MatiCruzate/Estaci-n-de-Audio-R-tmica/Modelo 3D/Caja_audio_ritmica.FCStd

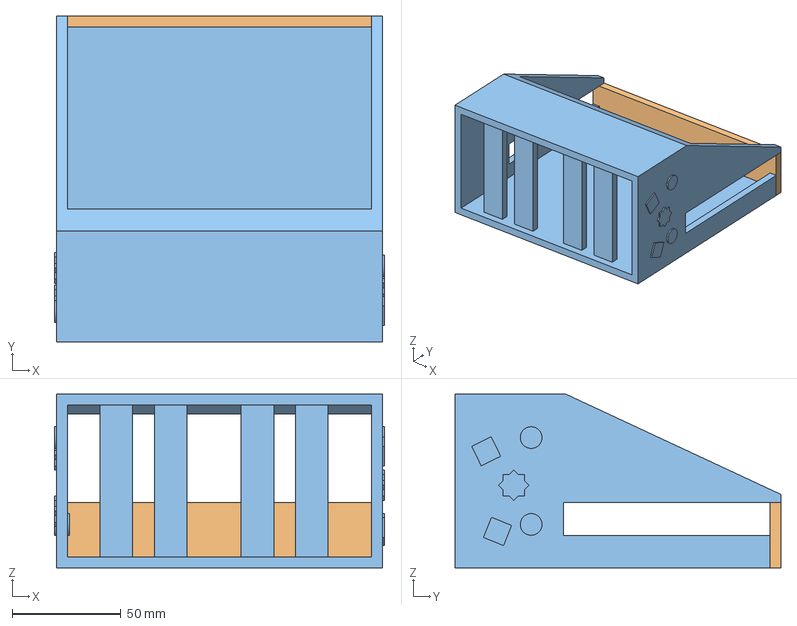
[picture p68: CAD file, 2024-02-26]
Modelo 3D/Caja_audio_ritmica.FCStd
152.0 x 150.0 x 80.0 mm
BooleanFragments
Cubo008
