MatiCruzate/Estaci-n-de-Audio-R-tmica/Modelo 3D/Caja_audio_ritmica-Fusion014.stl

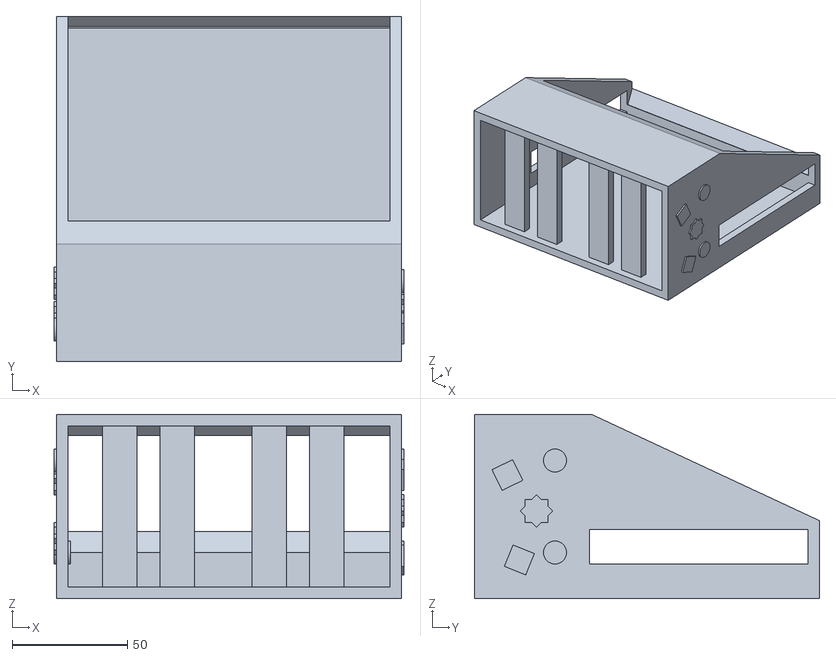
[picture p69: CAD file, 2024-02-26]
Modelo 3D/Caja_audio_ritmica-Fusion014.stl
152.0 x 150.0 x 80.0
