MatiCruzate/Estaci-n-de-Audio-R-tmica/Audio_Ritmica/Core/Src/main.c

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
/* Includes ------------------------------------------------------------------*/
#include "main.h"

/* USER CODE BEGIN Includes */
#include "arm_math.h"
#include <stdio.h>
#include <stdlib.h>
#include <math.h>
/* USER CODE END Includes */

/* USER CODE BEGIN PTD */
//Defino el valor para el ciclo activo del cero y el uno
//Se escriben en el capture compare register (pulse)
#define Neopixel_cero 38
#define Neopixel_uno 76
//Ahora veo la cantidad de pixels, osea leds, de mi matriz
#define Num_pixels 128
// Por cada uno tengo que enviar 24 bits mas 50 us de cero
#define DMA_BUFF_SIZE (Num_pixels*24+50)


//La idea es armar un arreglo de datos de 24 bits, 8 por cada color GRB, para mandar
typedef union Datos_shift
{
	//Hacer con aritmetrica de puntero
	uint32_t Datos32;
	uint16_t Datos16[2];
	uint8_t Datos8[4];
} datos;
uint8_t banda1=1;
uint8_t banda2=1;
uint8_t banda3=1;
uint8_t banda4=1;
uint8_t banda5=1;
uint8_t banda6=1;
uint8_t banda7=1;
uint8_t banda8=1;
/* USER CODE END PTD */

ADC_HandleTypeDef hadc1;

TIM_HandleTypeDef htim1;
TIM_HandleTypeDef htim2;
TIM_HandleTypeDef htim3;
TIM_HandleTypeDef htim4;
DMA_HandleTypeDef hdma_tim4_ch2;

void SystemClock_Config(void);
static void MX_GPIO_Init(void);
static void MX_DMA_Init(void);
static void MX_ADC1_Init(void);
static void MX_TIM3_Init(void);
static void MX_TIM4_Init(void);
static void MX_TIM1_Init(void);
static void MX_TIM2_Init(void);
/* USER CODE BEGIN 0 */
int i=0;
float32_t iir_int;
//A partir de acá definimos los filtros para luego copiar y pegar en el oficial
//Filtro 1
float32_t iir_coeff1[5]={0.02254,0,0,0.9775,0};
float32_t iir_state1[4]={0};
float32_t  iir_out1;
arm_biquad_casd_df1_inst_f32 S1;
//Filtro 2
float32_t iir_coeff2[10]={0.5,-0.5,0,0.9775,0,0.1,0.1,0,0.9582,0};
float32_t iir_state2[4*2]={0};
float32_t iir_out2;
arm_biquad_casd_df1_inst_f32 S2;
//Filtro 3
float32_t iir_coeff3[10]={0.5,-0.5,0,0.9582,0,0.25,0.25,0,0.918,0};
float32_t iir_state3[4*2]={0};
float32_t iir_out3;
arm_biquad_casd_df1_inst_f32 S3;
//Filtro 4
float32_t iir_coeff4[10]={1,-1,0,0.918,0,0.3,0.3,0,0.8425,0};
float32_t iir_state4[4*2]={0};
float32_t iir_out4;
arm_biquad_casd_df1_inst_f32 S4;
//Filtro 5
float32_t iir_coeff5[15]={0.5,-0.5,0,0.8425,0,0.6,0.6,0,0.708,0,0.25,0.25,0,0.708,0};
float32_t iir_state5[4*3]={0};
float32_t iir_out5;
arm_biquad_casd_df1_inst_f32 S5;
//Filtro 6
float32_t iir_coeff6[20]={1,-1,0,0.708,0,0.5,0.5,0,0.4747,0,0.5,0.5,0,0.4747,0,1,-1,0,0.708,0};
float32_t iir_state6[4*4]={0};
float32_t iir_out6;
arm_biquad_casd_df1_inst_f32 S6;
//Filtro 7
float32_t iir_coeff7[20]={1,-1,0,0.4747,0,1,1,0,0.168,0,1,-1,0,0.4747,0,0.5,0.5,0,0.168,0};
float32_t iir_state7[4*4]={0};
float32_t iir_out7;
arm_biquad_casd_df1_inst_f32 S7;
//Filtro 8
float32_t iir_coeff8[10]={1,-1,0,0.168,0,0.75,-0.75,0,0.168,0};
float32_t iir_state8[4*2]={0};
float32_t iir_out8;
arm_biquad_casd_df1_inst_f32 S8;

uint8_t contador_adc;
float max1=0;
float max2=0;
float max3=0;
float max4=0;
float max5=0;
float max6=0;
float max7=0;
float max8=0;
uint8_t caso_laser=0;
uint8_t prueba_pwm=0;
uint32_t pwm_H = 15;
uint8_t flag_pwm =0;
uint8_t flag2_pwm =0;
uint32_t pwm_L = 185;
uint16_t pwm_pulse;

uint16_t pwmDatos[DMA_BUFF_SIZE] = {0};
uint8_t Datos_Pixel[Num_pixels][4];
uint8_t Datos_Pixel_F[Num_pixels][4];

//Me armo una funcion que setee cada LED por separado
void Set_Pixel(uint8_t n, uint8_t Verde, uint8_t Rojo, uint8_t Azul)
{
	Datos_Pixel[n][0] = n;
	Datos_Pixel[n][1] = Verde;
	Datos_Pixel[n][2] = Rojo;
	Datos_Pixel[n][3] = Azul;

}


void vumetro(uint8_t banda1,uint8_t banda2,uint8_t banda3,uint8_t banda4,uint8_t banda5,uint8_t banda6,uint8_t banda7,uint8_t banda8){
//Hay que tener en cuenta que cada banda del vumetro son dos lineas de la matriz, pero
//por como se recorre una esta invertida
//colores: violeta, rosa, azul, dos verdes, amarillo, dos rojos
int numled=0;

switch(banda1){
case 1||0:
	Set_Pixel(0+numled,76,0,153);
	for(uint16_t j=1;j<=7;j++){
		Set_Pixel(j+numled,0,0,0);
	}
	Set_Pixel(8+numled,76,0,153);
	for(uint16_t j=9;j<=15;j++){
		Set_Pixel(j+numled,0,0,0);
	}
	break;
case 2:
	Set_Pixel(0+numled,0,76,153);
	Set_Pixel(1+numled,0,153,153);
	for(uint16_t j=2;j<=7;j++){
		Set_Pixel(j+numled,0,0,0);
	}
	Set_Pixel(8+numled,0,76,153);
	Set_Pixel(9+numled,0,153,153);
	for(uint16_t j=10;j<=15;j++){
		Set_Pixel(j+numled,0,0,0);
	}
	break;

case 3:
	Set_Pixel(0+numled,0,76,153);
	Set_Pixel(1+numled,0,153,153);
	Set_Pixel(2+numled,102,0,204);
	for(uint16_t j=3;j<=7;j++){
		Set_Pixel(j+numled,0,0,0);
	}
	Set_Pixel(8+numled,0,76,153);
	Set_Pixel(9+numled,0,153,153);
	Set_Pixel(10+numled,102,0,204);
	for(uint16_t j=11;j<=15;j++){
		Set_Pixel(j+numled,0,0,0);
	}
	break;
case 4:
	Set_Pixel(0+numled,0,76,153);
	Set_Pixel(1+numled,0,153,153);
	Set_Pixel(2+numled,102,0,204);
	Set_Pixel(3+numled,204,0,0);
	for(uint16_t j=4;j<=7;j++){
		Set_Pixel(j+numled,0,0,0);
	}
	Set_Pixel(8+numled,0,76,153);
	Set_Pixel(9+numled,0,153,153);
	Set_Pixel(10+numled,102,0,204);
	Set_Pixel(11+numled,204,0,0);
	for(uint16_t j=12;j<=15;j++){
		Set_Pixel(j+numled,0,0,0);
	}
	break;
case 5:
	Set_Pixel(0+numled,0,76,153);
	Set_Pixel(1+numled,0,153,153);
	Set_Pixel(2+numled,102,0,204);
	Set_Pixel(3+numled,204,0,0);
	Set_Pixel(4+numled,204,0,0);
	for(uint16_t j=5;j<=7;j++){
		Set_Pixel(j+numled,0,0,0);
	}
	Set_Pixel(8+numled,0,76,153);
	Set_Pixel(9+numled,0,153,153);
	Set_Pixel(10+numled,102,0,204);
	Set_Pixel(11+numled,204,0,0);
	Set_Pixel(12+numled,204,0,0);
	for(uint16_t j=13;j<=15;j++){
		Set_Pixel(j+numled,0,0,0);
	}
	break;
case 6:
	Set_Pixel(0+numled,0,76,153);
	Set_Pixel(1+numled,0,153,153);
	Set_Pixel(2+numled,102,0,204);
	Set_Pixel(3+numled,204,0,0);
	Set_Pixel(4+numled,204,0,0);
	Set_Pixel(5+numled,255,255,51);
	for(uint16_t j=6;j<=7;j++){
		Set_Pixel(j+numled,0,0,0);
	}
	Set_Pixel(8+numled,0,76,153);
	Set_Pixel(9+numled,0,153,153);
	Set_Pixel(10+numled,102,0,204);
	Set_Pixel(11+numled,204,0,0);
	Set_Pixel(12+numled,204,0,0);
	Set_Pixel(13+numled,255,255,51);
	for(uint16_t j=14;j<=15;j++){
		Set_Pixel(j+numled,0,0,0);
	}
	break;
case 7:
	Set_Pixel(0+numled,0,76,153);
	Set_Pixel(1+numled,0,153,153);
	Set_Pixel(2+numled,102,0,204);
	Set_Pixel(3+numled,204,0,0);
	Set_Pixel(4+numled,204,0,0);
	Set_Pixel(5+numled,255,255,51);
	Set_Pixel(6+numled,0,204,0);
	Set_Pixel(7+numled,0,0,0);
	Set_Pixel(8+numled,0,76,153);
	Set_Pixel(9+numled,0,153,153);
	Set_Pixel(10+numled,102,0,204);
	Set_Pixel(11+numled,204,0,0);
	Set_Pixel(12+numled,204,0,0);
	Set_Pixel(13+numled,255,255,51);
	Set_Pixel(14+numled,0,204,0);
	Set_Pixel(15+numled,0,0,0);
	break;
default:
	Set_Pixel(0+numled,0,76,153);
	Set_Pixel(1+numled,0,153,153);
	Set_Pixel(2+numled,102,0,204);
	Set_Pixel(3+numled,204,0,0);
	Set_Pixel(4+numled,204,0,0);
	Set_Pixel(5+numled,255,255,51);
	Set_Pixel(6+numled,0,204,0);
	Set_Pixel(7+numled,0,204,0);
	Set_Pixel(8+numled,0,76,153);
	Set_Pixel(9+numled,0,153,153);
	Set_Pixel(10+numled,102,0,204);
	Set_Pixel(11+numled,204,0,0);
	Set_Pixel(12+numled,204,0,0);
	Set_Pixel(13+numled,255,255,51);
	Set_Pixel(14+numled,0,204,0);
	Set_Pixel(15+numled,0,204,0);
	break;
}

numled=16;
switch(banda2){
case 1||0:
	Set_Pixel(0+numled,76,0,153);
	for(uint16_t j=1;j<=7;j++){
		Set_Pixel(j+numled,0,0,0);
	}
	Set_Pixel(8+numled,76,0,153);
	for(uint16_t j=9;j<=15;j++){
		Set_Pixel(j+numled,0,0,0);
	}
	break;
case 2:
	Set_Pixel(0+numled,0,76,153);
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
		if(max6>1000){
			banda6=8;
		}
		else{
			banda6=7;
		}
	}
	else{
		if(max6>730){
			banda6=6;
		}
		else{
			banda6=5;
		}
	}
}
else{
	if(max6>350){
		if(max6>500){
			banda6=4;
		}
		else{
			banda6=3;
		}
     }
	else{
		if(max6>200){
			banda6=2;
		}
		else{
			banda6=1;
		}
	}
}

//septimo arbol de ifs
if(max7>650){
	if(max7>950){
		if(max7>1050){
			banda7=8;
		}
		else{
			banda7=7;
		}
	}
	else{
		if(max7>830){
			banda7=6;
		}
		else{
			banda7=5;
		}
	}
}
else{
	if(max7>360){
		if(max7>520){
			banda7=4;
		}
		else{
			banda7=3;
		}
     }
	else{
		if(max7>200){
			banda7=2;
		}
		else{
			banda7=1;
		}
	}
}

//octavo arbol de ifs
if(max8>600){
	if(max8>800){
		if(max8>900){
			banda8=8;
		}
		else{
			banda8=7;
		}
	}
	else{
		if(max8>700){
			banda8=6;
		}
		else{
			banda8=5;
		}
	}
}
else{
	if(max8>350){
		if(max8>500){
			banda8=4;
		}
		else{
			banda8=3;
		}
     }
	else{
		if(max8>200){
			banda8=2;
		}
		else{
			banda8=1;
		}
	}
}

}

//Me armo una función que envíe los datos desde DMA a neopixeles

void Enviar_datos (void)
{
// Para el programa final trabajar a 24 fps
	//uint32_t datos;
	datos datos;
	uint16_t index = 0;


	for (int i = 0; i<Num_pixels; i++)
	{
		//si no funciona tambien deberia andar el codigo siguiente
		datos.Datos8[0]=Datos_Pixel[i][3];
		datos.Datos8[1]=Datos_Pixel[i][2];
		datos.Datos8[2]=Datos_Pixel[i][1];


		for (int i = 23; i>=0; i--)
		{

			if (datos.Datos32&(1<<i) ) pwmDatos[index] = Neopixel_uno; //ver counter&(1<<j)
			else pwmDatos[index] = Neopixel_cero;
			index++;

		}

	}

	for (int i=0; i<50;i++)
	{
		pwmDatos[index] = 0;
		index++;
	}



	//Envio la informacion con esta funcion de la HAL
/*		if(HAL_TIM_PWM_Start_DMA(&htim4, TIM_CHANNEL_2,(uint32_t *)pwmDatos,index)!=HAL_OK)
			{
			Error_Handler();
			};
			*/
	HAL_TIM_PWM_Start_DMA(&htim4, TIM_CHANNEL_2,(uint32_t *)pwmDatos,index);
	}


void HAL_TIM_PeriodElapsedCallback(TIM_HandleTypeDef *htim){
barras();

if(banda1>5 && banda2>6 && banda3>4 && banda4>4 && banda5>2)
{
switch(caso_laser)
{
//case 0: HAL_GPIO_TogglePin(GPIOC, LASER1_Pin);
case 0: GPIOC->ODR = 2;
break;
//case 1: 	HAL_GPIO_TogglePin(GPIOC, LASER2_Pin);
case 1: GPIOC->ODR = 4;
break;
}
caso_laser = (caso_laser+1)%2;

switch(prueba_pwm)
{
case 0:
pwm_H = 20;
pwm_L = 180;
break;
case 1:
pwm_H = 15;
pwm_L = 185;
break;
case 2:
pwm_H = 10;
pwm_L = 190;
break;
case 3:
pwm_H = 15;
pwm_L = 185;
break;
}
prueba_pwm = (prueba_pwm+1)%4;
}

Enviar_datos();
vumetro(banda1,banda2,banda3,banda4,banda5,banda6,banda7,banda8);
//Devuelvo los valores maximos de las bandas a su origen
max1=0;
max2=0;
max3=0;
max4=0;
max5=0;
max6=0;
max7=0;
max8=0;
}






void HAL_TIM_OC_DelayElapsedCallback (TIM_HandleTypeDef * htim){


if(htim->Channel == HAL_TIM_ACTIVE_CHANNEL_1){
	//pwm_pulse = HAL_TIM_ReadCapturedValue(htim, TIM_CHANNEL_1);
	pwm_pulse = TIM1->CCR1;
if(flag_pwm == 0)
{
	//__HAL_TIM_SET_COMPARE (htim, TIM_CHANNEL_1, (pwm_pulse+pwm_H)%60000);
	TIM1->CCR1 = (pwm_pulse+pwm_H)%60000;
	flag_pwm = 1;
}
else
{
	//__HAL_TIM_SET_COMPARE (htim, TIM_CHANNEL_1, (pwm_pulse+pwm_L)%60000);
	TIM1->CCR1 = (pwm_pulse+pwm_L)%60000;
	flag_pwm = 0;
}

}

if(htim->Channel == HAL_TIM_ACTIVE_CHANNEL_3){
	//pwm_pulse = HAL_TIM_ReadCapturedValue(htim, TIM_CHANNEL_3);
	pwm_pulse = TIM1->CCR3;
if(flag2_pwm == 0)
{
	//__HAL_TIM_SET_COMPARE (htim, TIM_CHANNEL_3, (pwm_pulse+pwm_H)%60000);
	TIM1->CCR3 = (pwm_pulse+pwm_H)%60000;
	flag2_pwm = 1;
}
else
{
	//__HAL_TIM_SET_COMPARE (htim, TIM_CHANNEL_3, (pwm_pulse+pwm_L)%60000);
	TIM1->CCR3 = (pwm_pulse+pwm_L)%60000;
	flag2_pwm = 0;
}
}
}


void HAL_ADC_ConvCpltCallback(ADC_HandleTypeDef* hadc)
{
iir_int = (float32_t)HAL_ADC_GetValue(&hadc1);
if(i<10)
{
i++;
	}
else
{
//Para usar los filtros
arm_biquad_cascade_df1_f32(&S1,&iir_int,&iir_out1,1);
arm_biquad_cascade_df1_f32(&S2,&iir_int,&iir_out2,1);
arm_biquad_cascade_df1_f32(&S3,&iir_int,&iir_out3,1);
arm_biquad_cascade_df1_f32(&S4,&iir_int,&iir_out4,1);
arm_biquad_cascade_df1_f32(&S5,&iir_int,&iir_out5,1);
arm_biquad_cascade_df1_f32(&S6,&iir_int,&iir_out6,1);
arm_biquad_cascade_df1_f32(&S7,&iir_int,&iir_out7,1);
arm_biquad_cascade_df1_f32(&S8,&iir_int,&iir_out8,1);


}
valor_maximo(iir_out1,iir_out2,iir_out3,iir_out4,iir_out5,iir_out6,iir_out7,iir_out8);

contador_adc++;

}



/* USER CODE END 0 */

/**
  * @brief  The application entry point.
  * @retval int
  */
int main(void)
{
  /* MCU Configuration--------------------------------------------------------*/

  /* Reset of all peripherals, Initializes the Flash interface and the Systick. */
  HAL_Init();

  /* Configure the system clock */
  SystemClock_Config();

  /* Initialize all configured peripherals */
  MX_GPIO_Init();
  MX_DMA_Init();
  MX_ADC1_Init();
  MX_TIM3_Init();
  MX_TIM4_Init();
  MX_TIM1_Init();
  MX_TIM2_Init();
  /* USER CODE BEGIN 2 */
  //Para inicializar los filtros

arm_biquad_cascade_df1_init_f32(&S1,1,&iir_coeff1[0],&iir_state1[0]);
arm_biquad_cascade_df1_init_f32(&S2,2,&iir_coeff2[0],&iir_state2[0]);
arm_biquad_cascade_df1_init_f32(&S3,2,&iir_coeff3[0],&iir_state3[0]);
arm_biquad_cascade_df1_init_f32(&S4,2,&iir_coeff4[0],&iir_state4[0]);
arm_biquad_cascade_df1_init_f32(&S5,3,&iir_coeff5[0],&iir_state5[0]);
arm_biquad_cascade_df1_init_f32(&S6,4,&iir_coeff6[0],&iir_state6[0]);
arm_biquad_cascade_df1_init_f32(&S7,4,&iir_coeff7[0],&iir_state7[0]);
arm_biquad_cascade_df1_init_f32(&S8,2,&iir_coeff8[0],&iir_state8[0]);


  HAL_ADC_Start_IT(&hadc1);
  HAL_TIM_PWM_Start(&htim2, TIM_CHANNEL_1);
  HAL_TIM_Base_Start_IT(&htim3);
  HAL_TIM_OC_Start_IT(&htim1, TIM_CHANNEL_1);
  HAL_TIM_OC_Start_IT(&htim1, TIM_CHANNEL_3);

  /* USER CODE END 2 */

  /* Infinite loop */
  /* USER CODE BEGIN WHILE */


  while (1)
  {
    /* USER CODE END WHILE */

    /* USER CODE BEGIN 3 */
  }
  /* USER CODE END 3 */
}

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
