MatiCruzate/Estaci-n-de-Audio-R-tmica/Audio_Ritmica/Audio_Ritmica.ioc

Mcu.UserName=STM32F411VETx
PA0-WKUP.Signal=GPXTI0
PA13.GPIO_Label=SWDIO
PA13.Signal=SYS_JTMS-SWDIO
PA14.GPIO_Label=SWCLK
PA14.Signal=SYS_JTCK-SWCLK
PA2.Signal=ADCx_IN2
PB7.Signal=S_TIM4_CH2
PC0.GPIO_Label=OTG_FS_PowerSwitchOn
PC0.Signal=GPIO_Output
PC1.Signal=GPIO_Output
PC14-OSC32_IN.GPIO_Label=PC14-OSC32_IN
PC14-OSC32_IN.Signal=RCC_OSC32_IN
PC15-OSC32_OUT.GPIO_Label=PC15-OSC32_OUT
PC15-OSC32_OUT.Signal=RCC_OSC32_OUT
PC2.Signal=GPIO_Output
PE13.Signal=S_TIM1_CH3
PE9.Signal=S_TIM1_CH1
