MatiCruzate/Estaci-n-de-Audio-R-tmica/(commit log)

2024-02-23 Modelos FreeCAD y simulaciones MATLAB
    [Caja_audio_ritmica-Fusion014.stl, Caja_audio_ritmica.FCStd]
2024-02-26 Proyecto final de audio ritmoca
2024-02-26 actualizacion de prueba iir1
2024-10-12 Actualizacion_12-10-2024
    Se agregan simulaciones con método de Monte Carlo y se actualiza la descripción del informe
