MatiCruzate/Estaci-n-de-Audio-R-tmica/(notices)

Notices in the files:
Audio_Ritmica/Core/Src/main.c:
Copyright (c) 2022 STMicroelectronics.
All rights reserved.
This software is licensed under terms that can be found in the LICENSE file
